aag224/MIK-I-Cheap-Platform/readme.md

# MIK-I

### Authors:
- Flores-Ortiz, M. A.
* López-López, E.R.
+ Aguilar-Granda, A.

#

This repository contains:

  + [Guide to running a synthesis](Guide.to.running.synthesis.codes.pdf)

  * [MIK-I setup](MIK-I_setup.pdf)

and python codes.
