aag224/MIK-I-Cheap-Platform/(list of files, cad)

Other CAD files:
model_dwg/modelCase_.dwg
