aag224/MIK-I-Cheap-Platform/guide/Guide.to.running.synthesis.codes.pdf

Guide to running synthesis codes.

1. To connect communication with the Raspberry Pi and set the operation time for a pin. It is necessary to import the following libraries: “RPi.GPIO” and “time”. Also, from the library, “time” import the module “sleep”.
2. To activate the electronic components, assign a specific "pin" number for each electronic part and each operation variable. For example, the "peristaltic pump 1" is defined as “pump1 = 13” . The magnetic stirring plate is defined as “stir=12”, and the stirring direction is defined as “lstir=20” and “rstir=21”.

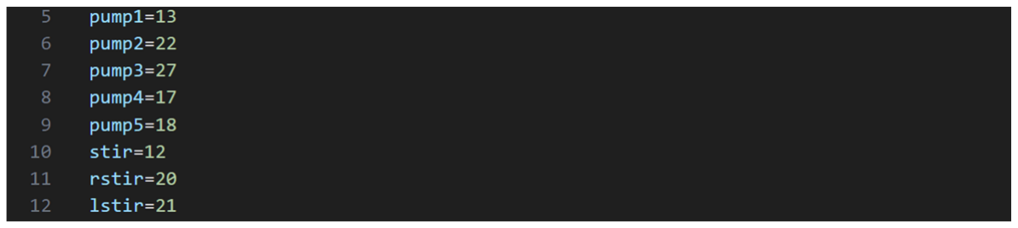
[picture p1: figure]

3. Set the mode to call a pin with its corresponding number with “GPIO.setmode(GPIO.BCM)” and set each pump pin as an output with the command “GPIO.setup(pump1, GPIO.OUT)”.

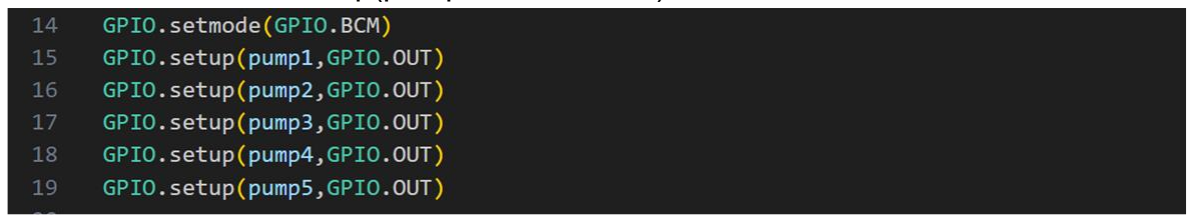
[picture p2: figure]

4. In the case of the magnetic stirring plate, define its pin as output using the command “GPIO.setup(stir, GPIO.OUT)” and the pins for directions using the command “GPIO.setup(rstir, GPIO.OUT)”. Also, it is necessary to define a
frequency | variable | at | which | the | stirring | plate | works | as
“pw_s=GPIO.PWM(stir,500)”. Finally, execute the work's operation using the command “pw_s.start(0)”.

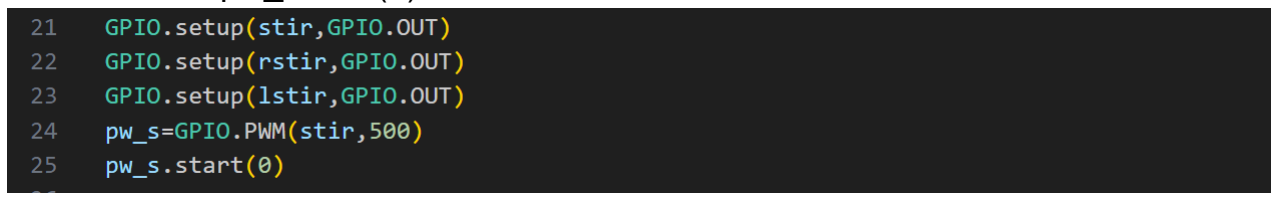
[picture p3: figure]

5. To establish the volume to add to the reaction vial, it is necessary to create variables in each pump defined as “volp1=float(input(“Volume_pump_1(mL): ’’))”. Also, a variable to answer Y/N defined as “charge=str(input(“Consider the load time? (Y/N)”))” to consider or rule out the load time during the operation time of each pump. Additionally, a list is created with the flow rate for each pump (flow=[ ]) and another list with the loading time for each pump (tc=[ ]).

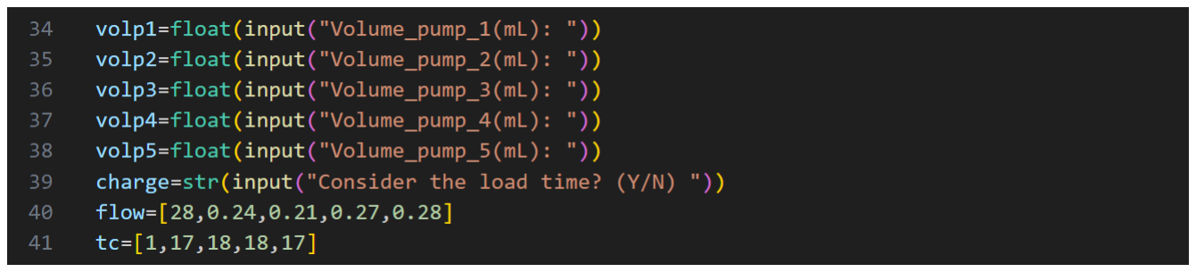
[picture p4: figure]

6. To get pumps to work, define for each pump a function as “def Pmp1( ):”. To turn ON the corresponding pump, it is necessary to utilize the command “GPIO.output(pump1,0)”. For easy visualization of the operation of the pumps “print(“Pump1_ON”)” to know that the pump is working and to establish the operation time working use the command “sleep(volp1/flow[0]+tc[0])”. Again, use “print(“Pump1_OFF”)” to know the pump is OFF, and to turn OFF the corresponding pump off, utilize the command “GPIO.output(pump1,1)”. Finally, to establish the end of the pump work, use the command “sleep(1)”. In this case, the work pump is already defined.

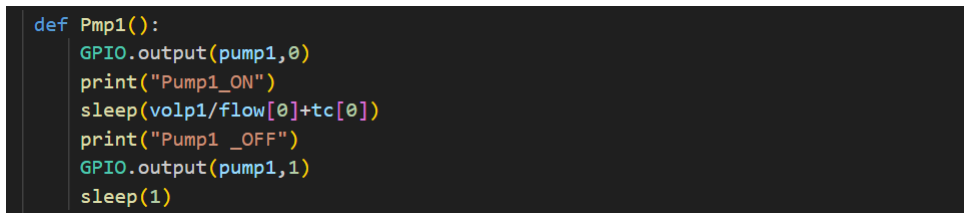
[picture p5: figure]

7. In the case of a magnetic stirrer plate, define the operation “def sti1():”. To turn ON the magnetic stirred plate use the command “GPIO.output(rstir,0)”. To know if the stir is working, use “print(“Stir_ON”))”. Also, to set the stirring velocity, use the command “pw_s.ChangeDutyCycle(65)”. The range of the velocity is from 0 to 100, select 65 to establish a medium velocity, enough for a reaction work. To establish the operation time of the stirring plate, use the command “sleep(5)”. This time will change according to the mixture time between reagents before adding another reagent or the reaction time with only stirring.

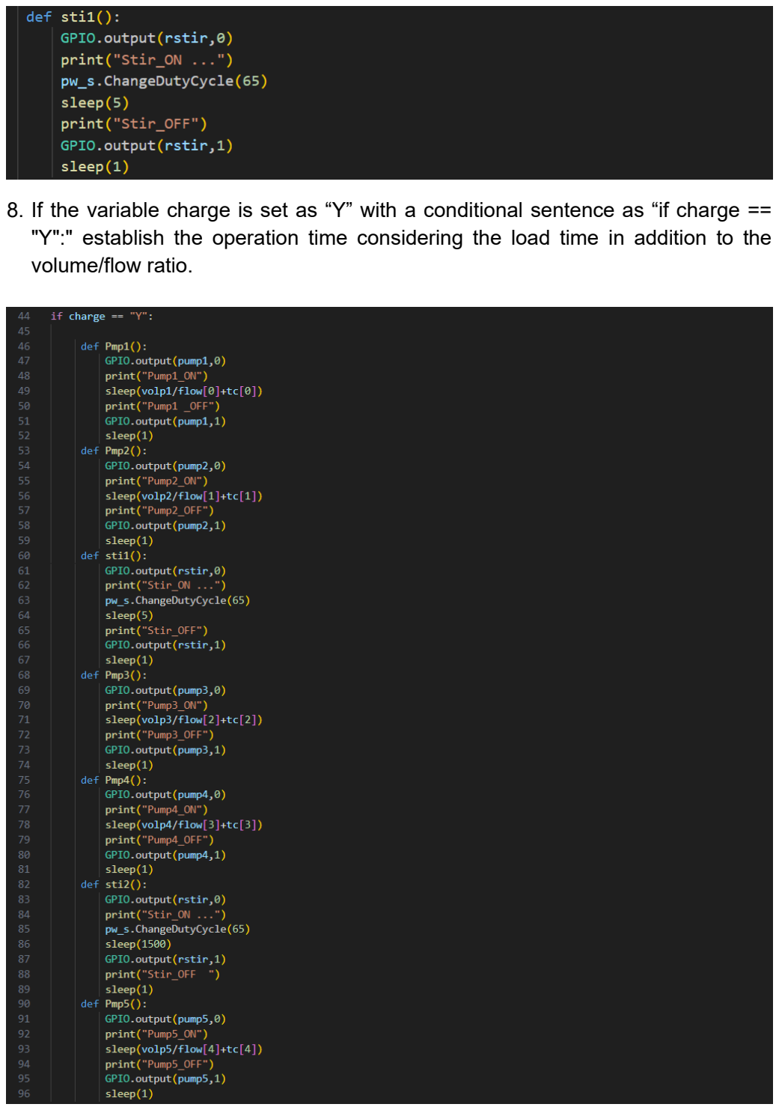
[picture p6: page 3]

8. If the variable charge is set as “Y” with a conditional sentence as “if charge == "Y":" establish the operation time considering the load time in addition to the volume/flow ratio.

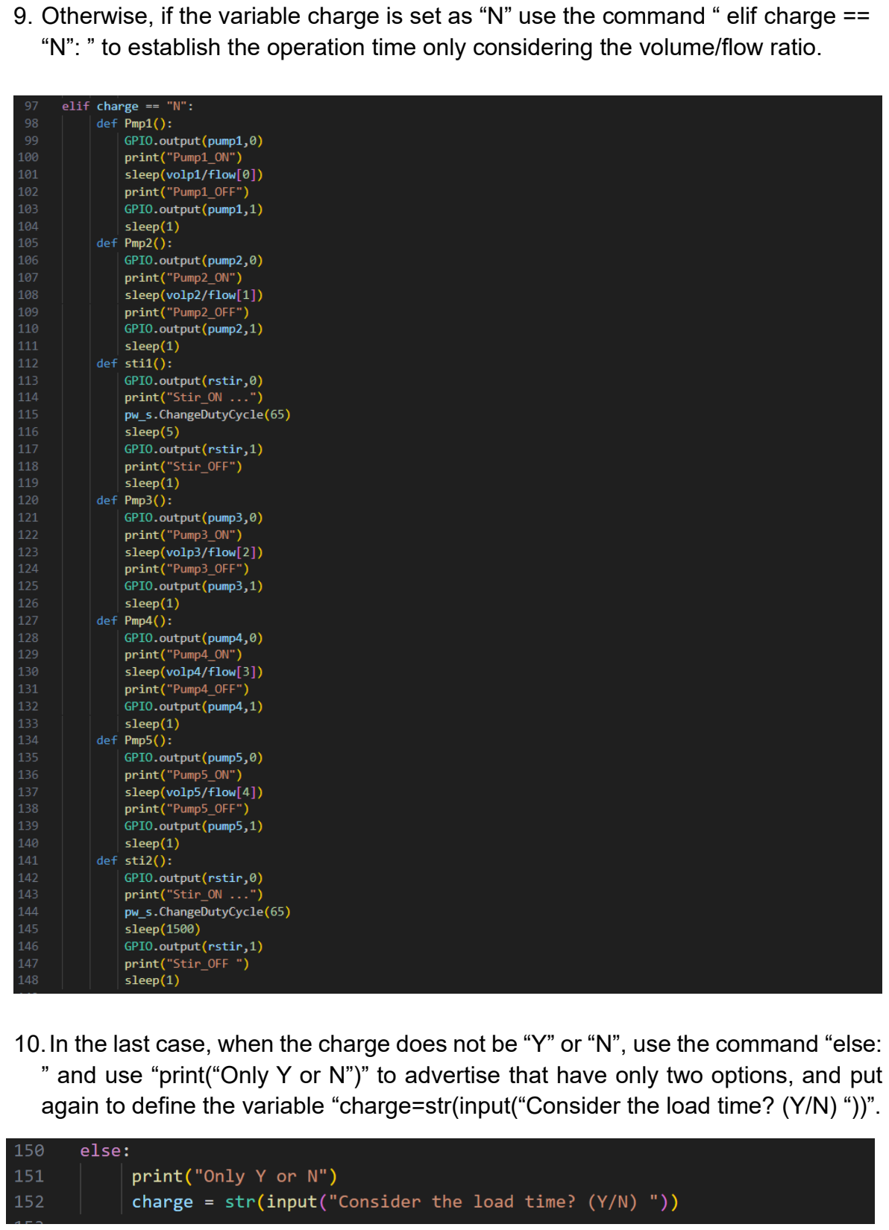
[picture p7: page 4]

9. Otherwise, if the variable charge is set as “N” use the command “ elif charge == “N”: ” to establish the operation time only considering the volume/flow ratio.

10.In the last case, when the charge does not be “Y” or “N”, use the command “else: ” and use “print(“Only Y or N”)” to advertise that have only two options, and put again to define the variable “charge=str(input(“Consider the load time? (Y/N) “))”.

11. Call the functions in order of appears, first appearance pump 2 “Pmp2()”, second appearance pump 3 “Pmp3()”, stirring “sti1()”, third appearance pump 3 “Pmp3()”, stir continues “sti1()”, fourth appearance pump 4 “Pmp4()”, stir continues “stir1()”, fifth and last appearance pump 5 “Pmp5()” and the stirring continues until the reaction time has elapsed “sti2()”. Finally, it is important to include the command “GPIO.cleanup()” to clean up all the pins that have been used.

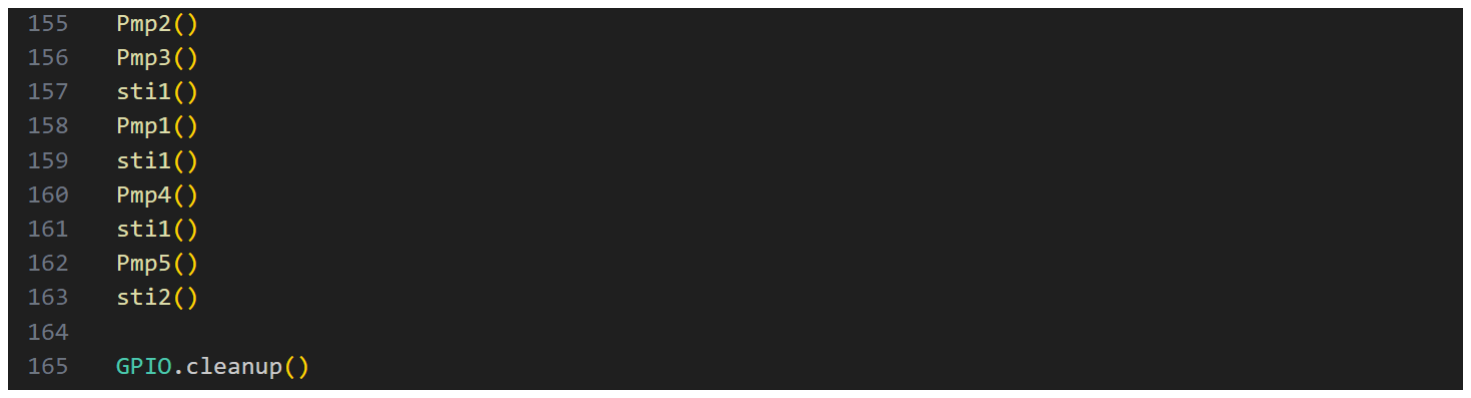
[picture p8: figure]
