aag224/MIK-I-Cheap-Platform/guide/mik_guide_setup.pdf

## MIK-I setup

## Building C-C bonds using a cheap automated synthesis platform

Miguel Alberto Flores-Ortiz, Ricardo A. Gutiérrez-Márquez, Rogelio S. Mier-Jiménez, Martha M. Flores-Leonar, Andrés Aguilar-Granda*

Facultad de Química, Universidad Nacional Autónoma de México, Ciudad Universitaria, 04510 Ciudad de México, México.

andres.aguilar@quimica.unam.mx

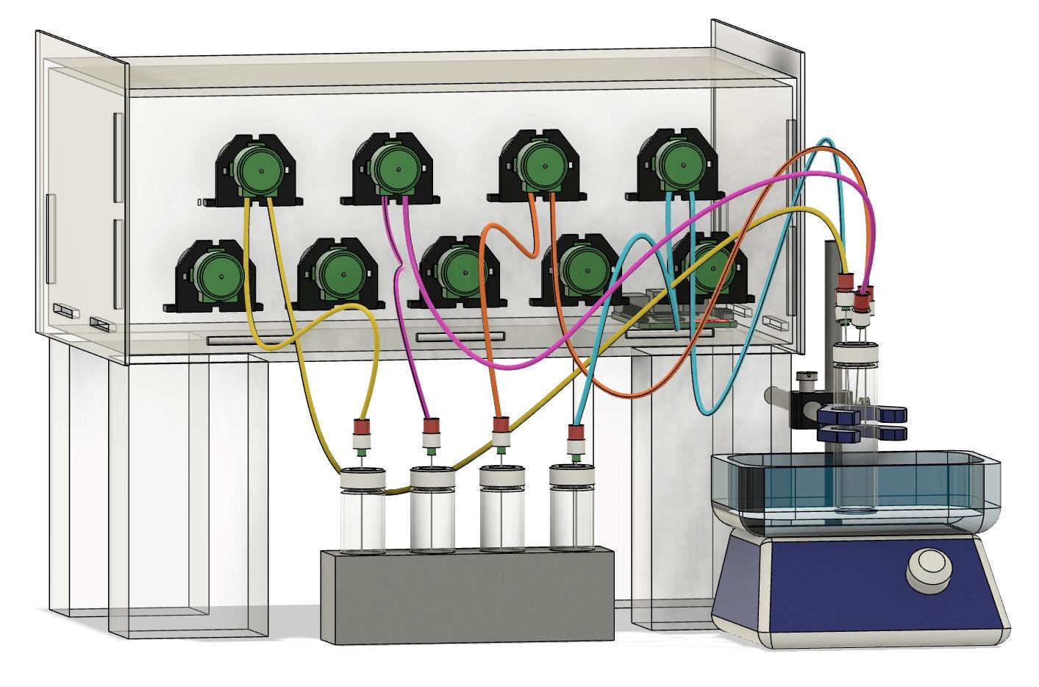
[picture p9: figure]

Figure 1. View general to MIK-setup

## Electronic system

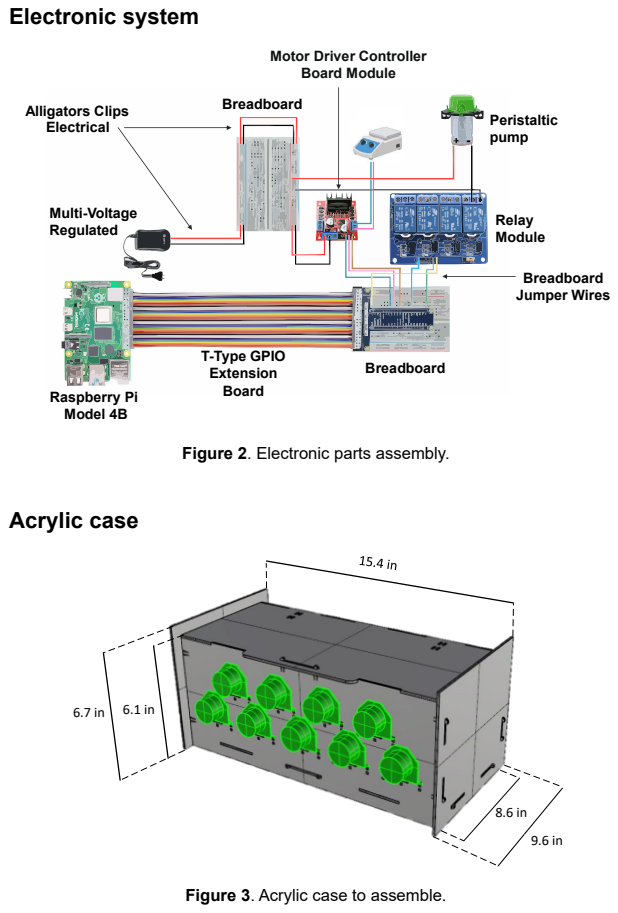
[picture p10: page 2]
Acrylic case; asp erry i Mo el; - ype; E tension oar; rea; oar; umper; ires; elay Mo ule; eristaltic pump; Multi- oltage egulate; Alligators lips Electrical

Motor ri er ontroller

oar Mo ule

Figure 2. Electronic parts assembly.

Figure 3. Acrylic case to assemble.

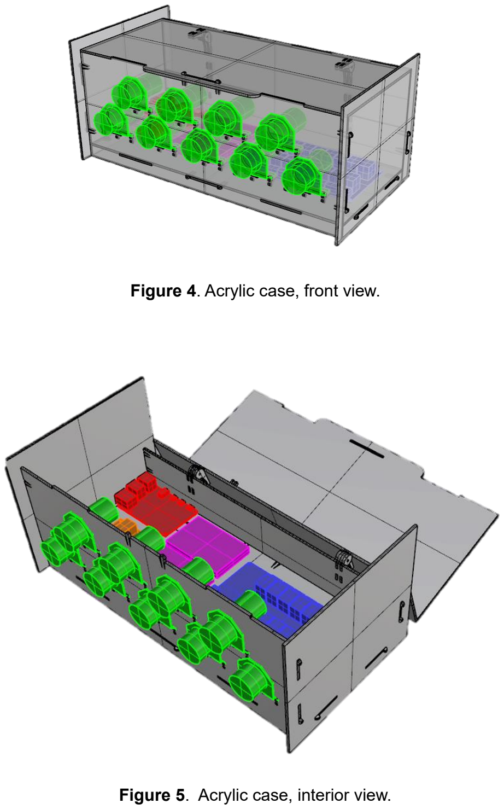
[picture p11: page 3]

Figure . Acrylic case, front view.

Figure 5. Acrylic case, interior view.

## MIK-I parts

a le 1. MIK-I parts

Quantity | Material | Image | Price

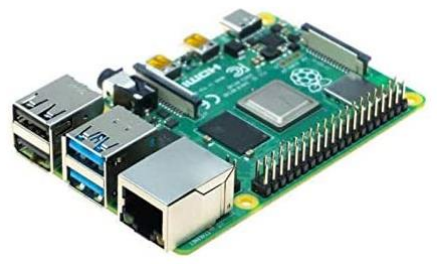
[picture p12: figure]

1 | Raspberry Pi Model 4B | | USD $144.99 (https://www.amazon.com.mx/Raspberry-Modelo-2019-Quad-Bluetooth/dp/B07TC2BK1X/)

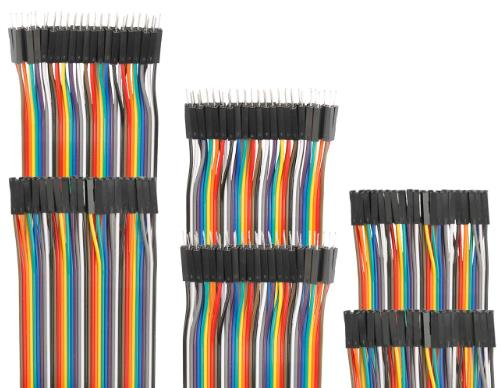
[picture p13: figure]

1 | 120 pcs Breadboard Jumper Wires 20 cm Assorted Cable | | USD $6.99 (https://www.amazon.com/EDGELEC-longitud-alambre-opcional-multicolor/dp/B07GD2BWPY?language=en_US)

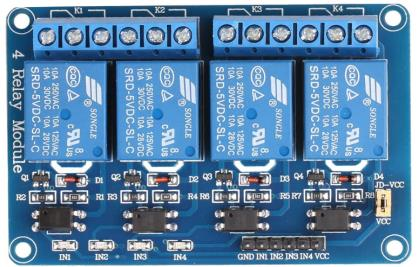
[picture p14: figure]

1 | 4 Channel DC 5V Relay Module for Arduino Raspberry Pi | | USD $7.99 (https://www.amazon.com/JBtek-Channel-Module-Arduino-Raspberry/dp/B00KTEN3TM)

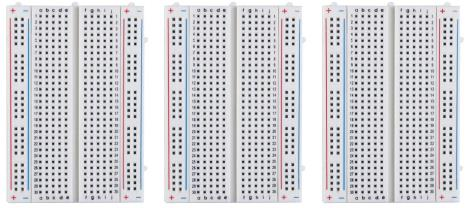
[picture p15: figure]

1 | 3 Pcs 400 Tie Point Experiment Mini Bread | | USD $7.99 (https://www.amazon.com/ELEGOO-tie-points-breadboard-Arduino-Jumper/dp/B01EV640I6)

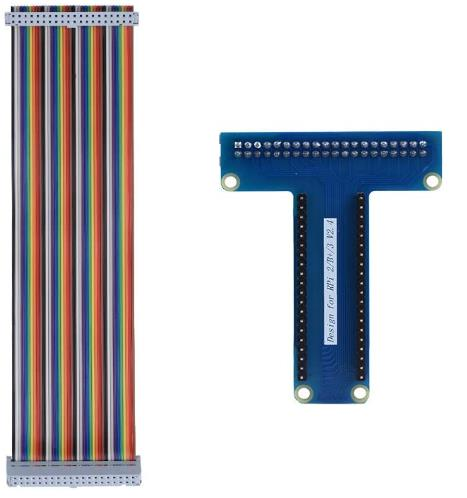
[picture p16: figure]

1 | T-Type GPIO Extension Board +40 pin Ribbon Flat Cable - Copper Core, Rainbow Looking -Applied to Breadboard Test - Extending Kit for Raspberry Pi | USD $8.39 (https://www.amazon.com/dp/B07NZ6RKTH?s=pc&sp_csd=d2lkZ2V0TmFtZT1zcF9kZXRhaWw)

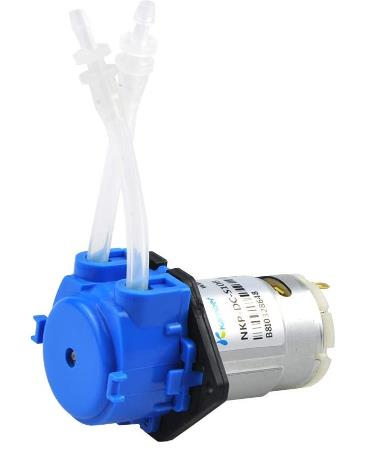
[picture p17: figure]

4 | Low Flow Peristaltic Pump 12 V | USD $9.98 (https://www.amazon.com/Kamoer-Peristaltic-Hydroponics-Nutrient-Analytical/dp/B07GWJ78FN)

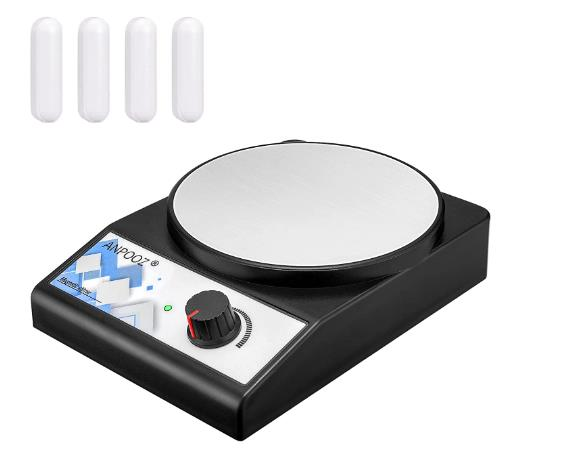
[picture p18: figure]

1 | Magnetic Stirrer with 4 pcs, Stir Plate 3000RPM Magnetic Mixer 3000 mL Lab Stirrers | USD $33.77 (https://www.amazon.com/ANPOOZ-Magnetic-Stirrer-3000RPM-Stirrers/dp/B09JP5PT1L)

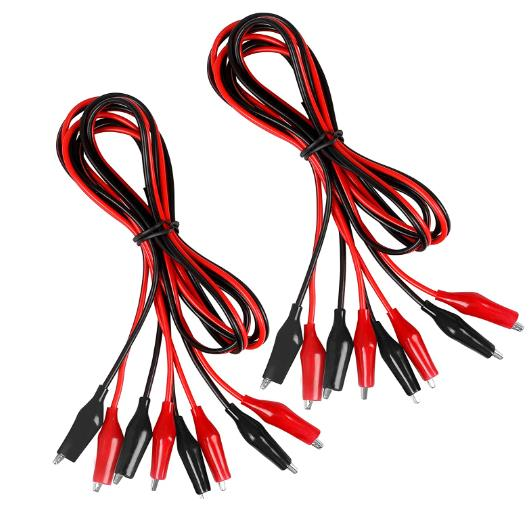
[picture p19: figure]

1 | 4 Groups !M Alligators Clips Electrical, Insulated Test Leads with Alligators Clips, Stamping Double -Ended Jumper Wires for Electrical Testing, Circuit Connection, Experiment (Red & Black) | USD $5.98 (https://www.amazon.com/Alligator-Electrical-Double-ended-Connection-Experiment/dp/B0924JMYX3)

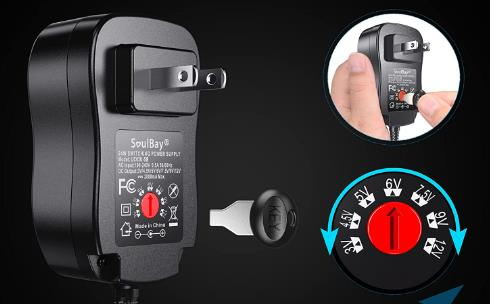
[picture p20: figure]

1 | Universal AC/DC Adapter Multi -Voltage Regulated Switching Power supply with 8 Selectable Adapter Plugs, for 3V to 12V | USD $15.98 (https://www.amazon.com/SoulBay-Universal-Multi-Voltage-Selectable-Electronics/dp/B01N2K48HR)

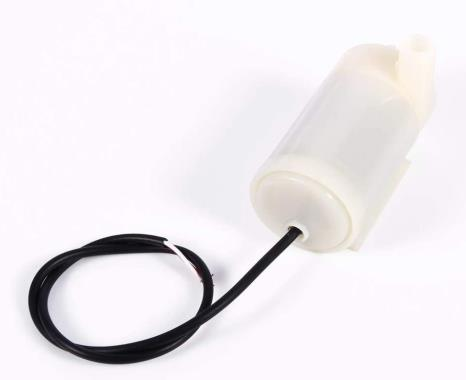
[picture p21: figure]

1 | Water Pumps, DC 3 -4.5V 100L/H Mini Micro Submersible Motor Pump Water Pumps Low Noise for Fish Tank Fountain Aquarium(JT -DC3W Horizontal) | USD $6.10 (https://www.amazon.com/Zerodis-Submersible-Fountain-Aquarium-Horizontal/dp/B07GTKRG6M)

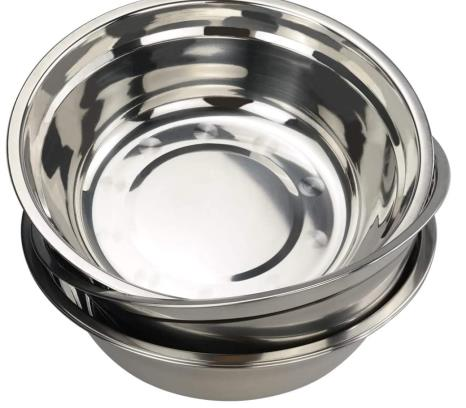
[picture p22: figure]

1 | Hommp 4 -Pack Large Stainless Steel Mixing Bowls/Metal Prep Bowls, 10 -Inch | USD $19.55 (https://www.amazon.com/Paquete-cuencos-inoxidable-preparaci%C3%B3n-pulgadas/dp/B07XFCTVTP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)

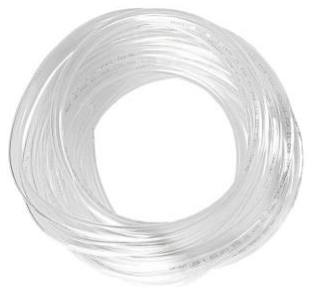
[picture p23: figure]

3 | Silicone tubing | USD $11.99 (https://www.amazon.com/10-Feet-Multipurpose-Kegerator-Aquaponics/dp/B01LWSPRCG?cv_ct_cx=silicone%2Btubing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)

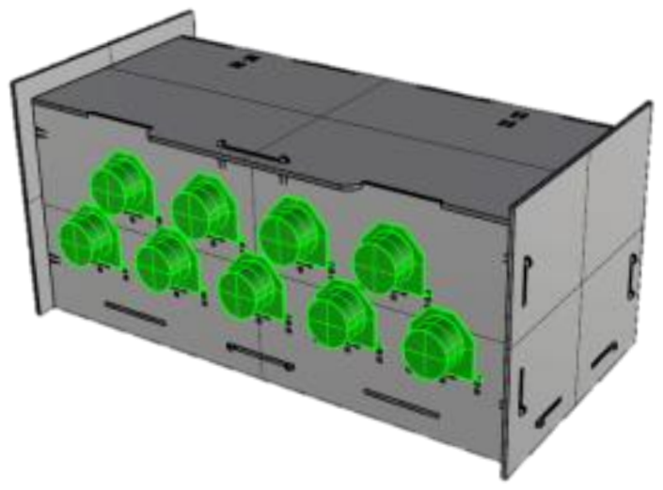
[picture p24: figure]

1 | acrylic box | USD $60
